ra0sms/Icom_CIV_banddecoder/DipTrace/3d_1.jpg

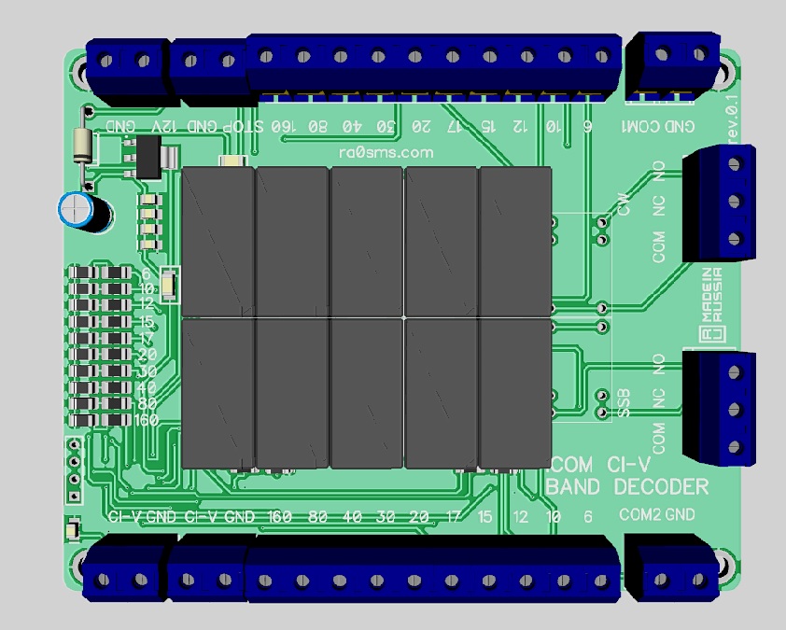
DipTrace/3d_1.jpg
