ra0sms/Icom_CIV_banddecoder/DipTrace/3d_2.jpg

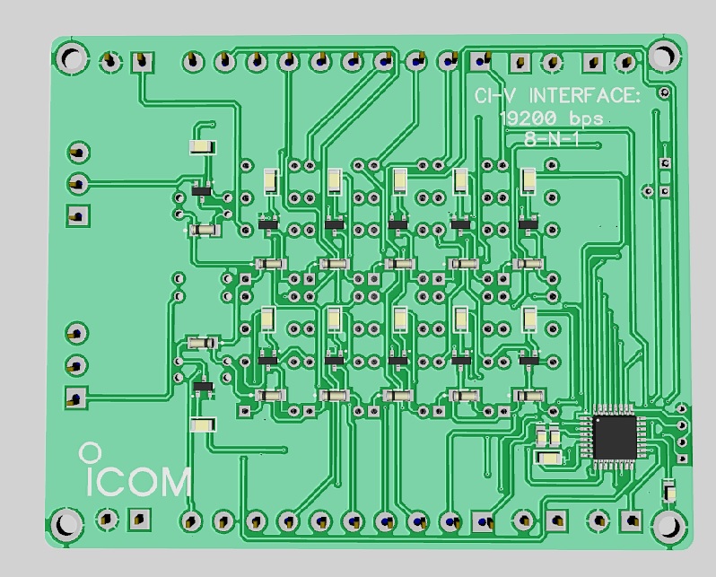
DipTrace/3d_2.jpg
