ra0sms/Icom_CIV_banddecoder/docs/civ_2.gif

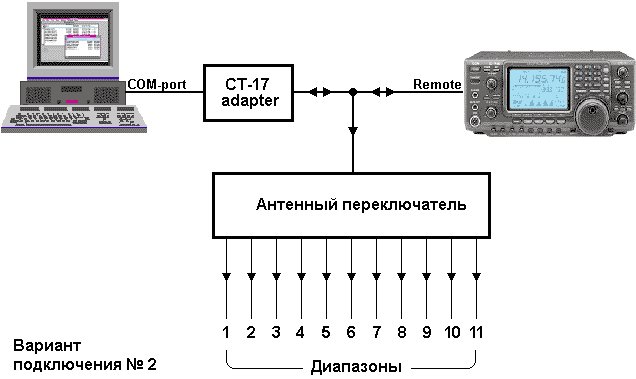
docs/civ_2.gif
