ra0sms/Icom_CIV_banddecoder/docs/civ_rdr.gif

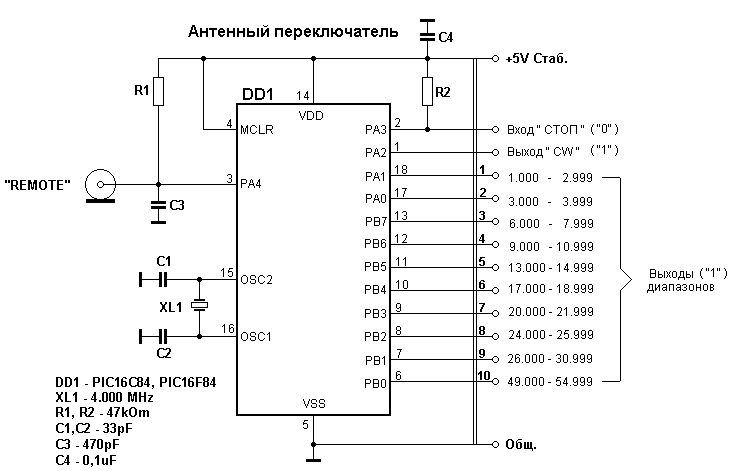
docs/civ_rdr.gif
