ra0sms/Icom_CIV_banddecoder/docs/pinout.jpg

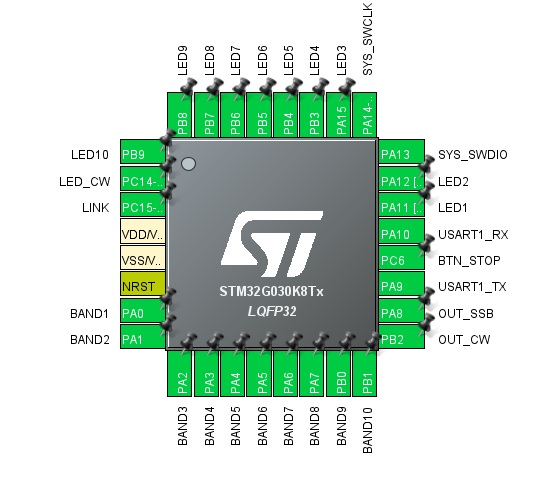
docs/pinout.jpg
