ra0sms/Icom_CIV_banddecoder/docs/st_link_connection.png

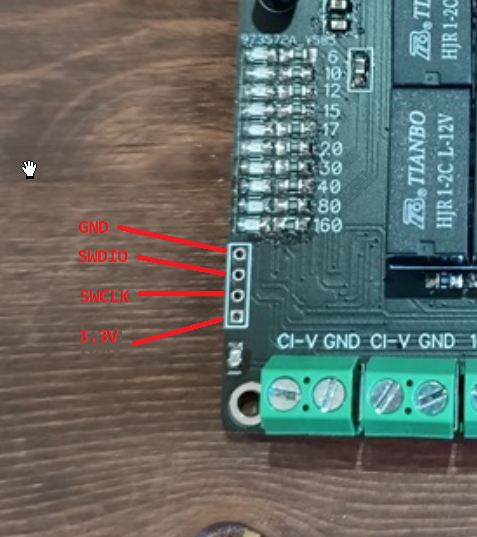
docs/st_link_connection.png
