ra0sms/Icom_CIV_banddecoder/(list of files, drawings)

Other design files:
DipTrace/Icom_BD_pcb.dip
DipTrace/Icom_BD_pcb_route2.dip
DipTrace/Icom_BD_pcb_route.dip
DipTrace/Icom_BD_sch.dch
