ra0sms/Icom_CIV_banddecoder/code/Core/Src/main.c

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
/* Includes ------------------------------------------------------------------*/
#include "main.h"

/* USER CODE BEGIN Includes */
#include "flash_storage.h"
#include "band_rules.h"
#include <string.h>

#define BAUD_RATE 19200


extern uint8_t cmd_buffer[256];
extern uint16_t cmd_index;
extern uint8_t cmd_ready;


// ===== ТАБЛИЦА ДИАПАЗОНОВ (кГц) =====
// верхняя граница НЕ включается
// нижняя граница включается
// C - CW
// P - PHONE
const band_rule_t band_rules_default[] = {

    {1800, 1840, 160, 'C'},
    {1840, 2000, 160, 'P'},

    {3500, 3600, 80, 'C'},
    {3600, 3800, 80, 'P'},

    {7000, 7050, 40, 'C'},
    {7050, 7200, 40, 'P'},

    {10100, 10150, 30, 'C'},

    {14000, 14110, 20, 'C'},
    {14110, 14350, 20, 'P'},

    {18068, 18110, 17, 'C'},
    {18110, 18168, 17, 'P'},

    {21000, 21110, 15, 'C'},
    {21110, 21450, 15, 'P'},

    {24890, 24920, 12, 'C'},
    {24920, 24990, 12, 'P'},

    {28000, 28300, 10, 'C'},
    {28300, 30000, 10, 'P'},

    {50000, 50200, 6, 'C'},
    {50200, 54000, 6, 'P'},

	{144000, 146000, 144, 'P'},
	{430000, 440000, 430, 'P'},
	{1240000, 1300000, 1200, 'P'},
	{2300000, 2450000, 2400, 'P'},
	{5650000, 5850000, 5000, 'P'},
	{10000000, 10500000, 10000, 'P'},
};

extern band_rule_t band_rules[];
extern uint8_t rules_count;


int flag_band=0;
char flag_mode=0;

/* USER CODE END Includes */

/* USER CODE BEGIN PM */

void led_blink_blocking(uint8_t times)
{
    for (uint8_t i = 0; i < times; i++) {

        LL_GPIO_SetOutputPin(LED_CW_GPIO_Port, LED_CW_Pin);
        HAL_Delay(100);

        LL_GPIO_ResetOutputPin(LED_CW_GPIO_Port, LED_CW_Pin);
        HAL_Delay(100);
    }
}

void process_uart_command(void)
{
    if (!cmd_ready) return;

    cmd_ready = 0;
    if (cmd_index < 4) {
        cmd_index = 0;
        led_blink_blocking(4);
        return;
    }
    if (cmd_buffer[0] != 0xAA) {
        cmd_index = 0;
        led_blink_blocking(4);
        return;
    }
    uint8_t count = cmd_buffer[1];
    if (count == 0 || count > MAX_RULES) {
        cmd_index = 0;
        led_blink_blocking(4);
        return;
    }
    uint16_t expected_size = 2 + count * 10 + 2;
    if (cmd_index != expected_size) {
        cmd_index = 0;
        led_blink_blocking(4);
        return;
    }

    if (cmd_buffer[cmd_index - 1] != 0x55) {
        cmd_index = 0;
        led_blink_blocking(4);
        return;
    }
    uint8_t crc = 0;
    for (uint16_t i = 0; i < cmd_index - 2; i++) {
        crc ^= cmd_buffer[i];
    }

    if (crc != cmd_buffer[cmd_index - 2]) {
        cmd_index = 0;
        led_blink_blocking(4);
        return;
    }
    band_rule_t new_rules[MAX_RULES];

    uint16_t offset = 2;

    for (uint8_t i = 0; i < count; i++) {
        new_rules[i].start_khz =
            (uint32_t)cmd_buffer[offset] |
            ((uint32_t)cmd_buffer[offset + 1] << 8) |
            ((uint32_t)cmd_buffer[offset + 2] << 16) |
            ((uint32_t)cmd_buffer[offset + 3] << 24);
        offset += 4;
        new_rules[i].end_khz =
            (uint32_t)cmd_buffer[offset] |
            ((uint32_t)cmd_buffer[offset + 1] << 8) |
            ((uint32_t)cmd_buffer[offset + 2] << 16) |
            ((uint32_t)cmd_buffer[offset + 3] << 24);
        offset += 4;
        new_rules[i].band = cmd_buffer[offset++];
        new_rules[i].mode = cmd_buffer[offset++];
    }
    if (!flash_save_rules(new_rules, count)) {
        cmd_index = 0;
        led_blink_blocking(4);
        return;
    }
    memcpy(band_rules, new_rules, count * sizeof(band_rule_t));
    rules_count = count;
    led_blink_blocking(2); // if OK
    cmd_index = 0;
}

void ResetOuts() {
	LL_GPIO_ResetOutputPin(BAND1_GPIO_Port, BAND1_Pin);
	LL_GPIO_ResetOutputPin(BAND2_GPIO_Port, BAND2_Pin);
	LL_GPIO_ResetOutputPin(BAND3_GPIO_Port, BAND3_Pin);
	LL_GPIO_ResetOutputPin(BAND4_GPIO_Port, BAND4_Pin);
	LL_GPIO_ResetOutputPin(BAND5_GPIO_Port, BAND5_Pin);
	LL_GPIO_ResetOutputPin(BAND6_GPIO_Port, BAND6_Pin);
	LL_GPIO_ResetOutputPin(BAND7_GPIO_Port, BAND7_Pin);
	LL_GPIO_ResetOutputPin(BAND8_GPIO_Port, BAND8_Pin);
	LL_GPIO_ResetOutputPin(BAND9_GPIO_Port, BAND9_Pin);
	LL_GPIO_ResetOutputPin(BAND10_GPIO_Port, BAND10_Pin);
}


void ResetLeds() {
	LL_GPIO_ResetOutputPin(LED1_GPIO_Port, LED1_Pin);
	LL_GPIO_ResetOutputPin(LED2_GPIO_Port, LED2_Pin);
	LL_GPIO_ResetOutputPin(LED3_GPIO_Port, LED3_Pin);
	LL_GPIO_ResetOutputPin(LED4_GPIO_Port, LED4_Pin);
	LL_GPIO_ResetOutputPin(LED5_GPIO_Port, LED5_Pin);
	LL_GPIO_ResetOutputPin(LED6_GPIO_Port, LED6_Pin);
	LL_GPIO_ResetOutputPin(LED7_GPIO_Port, LED7_Pin);
	LL_GPIO_ResetOutputPin(LED8_GPIO_Port, LED8_Pin);
	LL_GPIO_ResetOutputPin(LED9_GPIO_Port, LED9_Pin);
	LL_GPIO_ResetOutputPin(LED10_GPIO_Port, LED10_Pin);
}

void SetBand(int x){
	ResetOuts();
	switch (x){
	case 1: LL_GPIO_SetOutputPin(BAND1_GPIO_Port, BAND1_Pin); break;
	case 2: LL_GPIO_SetOutputPin(BAND2_GPIO_Port, BAND2_Pin); break;
	case 3: LL_GPIO_SetOutputPin(BAND3_GPIO_Port, BAND3_Pin); break;
	case 4: LL_GPIO_SetOutputPin(BAND4_GPIO_Port, BAND4_Pin); break;
	case 5: LL_GPIO_SetOutputPin(BAND5_GPIO_Port, BAND5_Pin); break;
	case 6: LL_GPIO_SetOutputPin(BAND6_GPIO_Port, BAND6_Pin); break;
	case 7: LL_GPIO_SetOutputPin(BAND7_GPIO_Port, BAND7_Pin); break;
	case 8: LL_GPIO_SetOutputPin(BAND8_GPIO_Port, BAND8_Pin); break;
	case 9: LL_GPIO_SetOutputPin(BAND9_GPIO_Port, BAND9_Pin); break;
	case 10: LL_GPIO_SetOutputPin(BAND10_GPIO_Port, BAND10_Pin); break;
	}
}

void SetLed(int x){
	ResetLeds();
	switch (x){
	case 1: LL_GPIO_SetOutputPin(LED1_GPIO_Port, LED1_Pin); break;
	case 2: LL_GPIO_SetOutputPin(LED2_GPIO_Port, LED2_Pin); break;
	case 3: LL_GPIO_SetOutputPin(LED3_GPIO_Port, LED3_Pin); break;
	case 4: LL_GPIO_SetOutputPin(LED4_GPIO_Port, LED4_Pin); break;
	case 5: LL_GPIO_SetOutputPin(LED5_GPIO_Port, LED5_Pin); break;
	case 6: LL_GPIO_SetOutputPin(LED6_GPIO_Port, LED6_Pin); break;
	case 7: LL_GPIO_SetOutputPin(LED7_GPIO_Port, LED7_Pin); break;
	case 8: LL_GPIO_SetOutputPin(LED8_GPIO_Port, LED8_Pin); break;
	case 9: LL_GPIO_SetOutputPin(LED9_GPIO_Port, LED9_Pin); break;
	case 10: LL_GPIO_SetOutputPin(LED10_GPIO_Port, LED10_Pin); break;
	}
}

void SetMode() {
	if (flag_mode == 'C') {
		LL_GPIO_SetOutputPin(OUT_CW_GPIO_Port, OUT_CW_Pin);
		LL_GPIO_ResetOutputPin(OUT_SSB_GPIO_Port, OUT_SSB_Pin);
		LL_GPIO_ResetOutputPin(LED_CW_GPIO_Port, LED_CW_Pin);
	}
	if (flag_mode == 'P') {
		LL_GPIO_ResetOutputPin(OUT_CW_GPIO_Port, OUT_CW_Pin);
		LL_GPIO_SetOutputPin(OUT_SSB_GPIO_Port, OUT_SSB_Pin);
		LL_GPIO_SetOutputPin(LED_CW_GPIO_Port, LED_CW_Pin);
	}
	if (flag_mode == 0) {
		LL_GPIO_ResetOutputPin(OUT_CW_GPIO_Port, OUT_CW_Pin);
		LL_GPIO_ResetOutputPin(OUT_SSB_GPIO_Port, OUT_SSB_Pin);
		LL_GPIO_ResetOutputPin(LED_CW_GPIO_Port, LED_CW_Pin);
	}
}

void SetOut(void) {
	if (flag_band == 160) {
		SetLed(1);
		SetBand(1);
	}
	if (flag_band == 80) {
		SetLed(2);
		SetBand(2);
	}
	if (flag_band == 40) {
		SetLed(3);
		SetBand(3);
	}
	if (flag_band == 30) {
		SetLed(4);
		SetBand(4);
	}
	if (flag_band == 20) {
		SetLed(5);
		SetBand(5);
	}
	if (flag_band == 17) {
		SetLed(6);
		SetBand(6);
	}
	if (flag_band == 15) {
		SetLed(7);
		SetBand(7);
	}
	if (flag_band == 12) {
		SetLed(8);
		SetBand(8);
	}
	if (flag_band == 10) {
		SetLed(9);
		SetBand(9);
	}
	if (flag_band == 6) {
		SetLed(10);
		SetBand(10);
	}
	if (flag_band == 0) {
		ResetLeds();
		ResetOuts();
	}
	if (flag_band == 144) {
			SetLed(1);
			SetBand(1);
		}
	if (flag_band == 430) {
			SetLed(2);
			SetBand(2);
		}
	if (flag_band == 1200) {
			SetLed(3);
			SetBand(3);
		}
	if (flag_band == 2400) {
			SetLed(4);
			SetBand(4);
		}
	if (flag_band == 5000) {
			SetLed(5);
			SetBand(5);
		}
	if (flag_band == 10000) {
			SetLed(6);
			SetBand(6);
		}

}

void SetOut_UN3M(void) {
	if (flag_band == 160) {
		SetLed(1);
		SetBand(1);
	}
	if (flag_band == 80) {
		SetLed(2);
		SetBand(2);
	}
	if (flag_band == 40) {
		SetLed(3);
		SetBand(3);
	}
	if (flag_band == 30) {
		SetLed(4);
		SetBand(4);
	}
	if (flag_band == 20) {
		SetLed(5);
		SetBand(5);
	}
	if (flag_band == 17) {
		SetLed(6);
		SetBand(6);
	}
	if (flag_band == 15) {
		SetLed(7);
		SetBand(7);
	}
	if (flag_band == 12) {
		SetLed(8);
		SetBand(8);
	}
	if (flag_band == 10) {
		SetLed(7);
		SetBand(7);
	}
	if (flag_band == 6) {
		SetLed(10);
		SetBand(10);
	}
	if (flag_band == 60) {
			SetLed(9);
			SetBand(9);
		}
	if (flag_band == 0) {
		ResetLeds();
		ResetOuts();
	}

}

/* USER CODE END PM */


void SystemClock_Config(void);
static void MX_GPIO_Init(void);
static void MX_USART1_UART_Init(void);
static void MX_TIM14_Init(void);
/**
  * @brief  The application entry point.
  * @retval int
  */
int main(void)
{
  /* MCU Configuration--------------------------------------------------------*/

  /* Reset of all peripherals, Initializes the Flash interface and the Systick. */
  HAL_Init();

  /* Configure the system clock */
  SystemClock_Config();

  /* Initialize all configured peripherals */
  MX_GPIO_Init();
  MX_USART1_UART_Init();
  MX_TIM14_Init();
  /* USER CODE BEGIN 2 */
  rules_count = flash_load_rules(band_rules, MAX_RULES);
  if (rules_count == 0) {
      memcpy(band_rules, band_rules_default, sizeof(band_rules_default));
      rules_count = sizeof(band_rules_default) / sizeof(band_rules_default[0]);

      flash_save_rules(band_rules, rules_count);
  }
  LL_TIM_EnableCounter(TIM14);
  LL_TIM_EnableIT_UPDATE(TIM14);
  LL_USART_EnableIT_RXNE(USART1);
  /* USER CODE END 2 */

  /* USER CODE BEGIN WHILE */
	while (1) {
		if (LL_GPIO_IsInputPinSet(BTN_STOP_GPIO_Port, BTN_STOP_Pin) == 1) {
			SetOut();
			SetMode();
		}
		process_uart_command();
		LL_mDelay(200);
		/* USER CODE END WHILE */

		/* USER CODE BEGIN 3 */
	}
  /* USER CODE END 3 */
}

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
