ra0sms/Icom_CIV_banddecoder/code/Core/Inc/main.h

#define LED10_Pin LL_GPIO_PIN_9
#define LED10_GPIO_Port GPIOB
#define LED_CW_Pin LL_GPIO_PIN_14
#define LED_CW_GPIO_Port GPIOC
#define LINK_Pin LL_GPIO_PIN_15
#define LINK_GPIO_Port GPIOC
#define BAND1_Pin LL_GPIO_PIN_0
#define BAND1_GPIO_Port GPIOA
#define BAND2_Pin LL_GPIO_PIN_1
#define BAND2_GPIO_Port GPIOA
#define BAND3_Pin LL_GPIO_PIN_2
#define BAND3_GPIO_Port GPIOA
#define BAND4_Pin LL_GPIO_PIN_3
#define BAND4_GPIO_Port GPIOA
#define BAND5_Pin LL_GPIO_PIN_4
#define BAND5_GPIO_Port GPIOA
#define BAND6_Pin LL_GPIO_PIN_5
#define BAND6_GPIO_Port GPIOA
#define BAND7_Pin LL_GPIO_PIN_6
#define BAND7_GPIO_Port GPIOA
#define BAND8_Pin LL_GPIO_PIN_7
#define BAND8_GPIO_Port GPIOA
#define BAND9_Pin LL_GPIO_PIN_0
#define BAND9_GPIO_Port GPIOB
#define BAND10_Pin LL_GPIO_PIN_1
#define BAND10_GPIO_Port GPIOB
#define OUT_CW_Pin LL_GPIO_PIN_2
#define OUT_CW_GPIO_Port GPIOB
#define OUT_SSB_Pin LL_GPIO_PIN_8
#define OUT_SSB_GPIO_Port GPIOA
#define BTN_STOP_Pin LL_GPIO_PIN_6
#define BTN_STOP_GPIO_Port GPIOC
#define LED1_Pin LL_GPIO_PIN_11
#define LED1_GPIO_Port GPIOA
#define LED2_Pin LL_GPIO_PIN_12
#define LED2_GPIO_Port GPIOA
#define LED3_Pin LL_GPIO_PIN_15
#define LED3_GPIO_Port GPIOA
#define LED4_Pin LL_GPIO_PIN_3
#define LED4_GPIO_Port GPIOB
#define LED5_Pin LL_GPIO_PIN_4
#define LED5_GPIO_Port GPIOB
#define LED6_Pin LL_GPIO_PIN_5
#define LED6_GPIO_Port GPIOB
#define LED7_Pin LL_GPIO_PIN_6
#define LED7_GPIO_Port GPIOB
#define LED8_Pin LL_GPIO_PIN_7
#define LED8_GPIO_Port GPIOB
#define LED9_Pin LL_GPIO_PIN_8
#define LED9_GPIO_Port GPIOB
